cdcortesr/PowerSupplyDC_DC/README.md

# PowerSupplyDC_DC
Vin=34V, Vout=12V Iout=2A nom.
