cdcortesr/PowerSupplyDC_DC/Design.txt

3.5 x 1.5 mm	1206
2 x 1 mm	0805
10 x 10 mm 	ind 6r8
1.18 in x 0.86 (1.02) in

TS34063CS	Output switch current up to 1.5A
LTC1624		Peak Driver Output Current < 10µs (TG) ..... 2A
LM5085		4.5-V to 75-V Input Voltage Range
LM25085		4.5-V to 75-V Input Voltage Range
tl5001		missing design equations

Vin=34V
Vout=12v
Iout=2A max 4A

Max current different from peak switching current

SW Ipk=4.58 A

RFB2/RFB1 = (VOUT/1.25V) - 1 
RFB2= 80K6	RFB1= 9K372 = 270R + 9K1
Selected PFET: SQ3419AEEV-T1_GE3 max vds = -40V

the switching node area is kept to a reasonable minimum and the PFET peak current is derated to stay
within the recommended temperature rating of the PFET. The RDS(ON) of the PFET determines a portion of the
power dissipation in the PFET. However, PFETs with very low RDS(ON) usually have large values of gate charge.
A PFET with a higher gate charge has a corresponding slower switching speed, leading to higher switching
losses and affecting the PFET power dissipation.

Input operating current=1.25mA @ Vin=34V and =1.3mA @ Vin=40V
=======
Diode: MM3Z20VT1G better to use shottky: SK810L-TP

PMOS: SQ3419AEEV
