cdcortesr/PowerSupplyDC_DC/DesignCalculations.xlsx

Vin | 32
Vout | 12
Duty cycle | 0.375
Ton | 3.75e-07 | Should not be less than 150ns |  |  |  | Calculated 375ns
Td mosf | 2.3e-08 |  |  |  |  | 67 ns for Vishay SQ3419AEEV |  |  | 29-6
Td mosf + IC | 7.3e-08 | off-on delay in mosfet +50ns
Load maxcurrent | 3
Ripple current | 1 |  |  |  |  |  |  |  | Sink current | Offset voltage | -0.009 | 0 | 0.009
Icl (min) | 3.5 | Max current + half ripple |  |  |  |  |  |  | Min | 3.2e-05 | 3.58 | 4.48 | 5.38
Rsense | 0.01 |  |  |  |  |  |  |  | Nominal | 4e-05 | 4.7 | 5.6 | 6.5
Rsense Volt | 0.035 |  | Minimum voltage drop required to achieve Load max curr. |  |  |  |  |  | Max | 4.8e-05 | 5.82 | 6.72 | 7.62
min tripping voltage | 0.044 | + 9 mV max comp offset
Current at min trip voltage | 4.4
Radj | 1375 | Worst case scenario Radj using lowest sink current 32uA
Next avail res | 1400 |  | next higher avail value
I cl max | 7.62
I cl min | 3.58
Max power Radj | 0.036576
Max power Rsense | 0.580644
Freq | 1000000
Ton | 3.75e-07 | Should not be less than 150ns
Vin Ripple | 0.1
Cin | 1.125e-05
Cin Commercial | 1e-06 | 1uF | A higher value cap allowes for smaller Vin Ripple
Vf diode | 0.45 |  | 0.43 @25C |  | STPS5L60 | 5.4 x 3.625 mm |  | Max power 144W
D1 power | 1.035791075 | Must stand max Vin
Cvcc | 1uF | 0.47uF ceremic low ESR recommended
Rt | 63.31124138 |  | Calc value= 63k2 Ohms |  |  | Rt value in kOmhs
Comercial RT | 63.4 | E48 | Value in Kohms
Resulting Fsw | 983039.4683 |  | 0.983 Mhz
 |  | +Delay |  |  |  |  |  | SW of 1 Mhz just achieved at Vin=32V
Ton(min) @Vin max=42V | 2.822292536e-07 | 3.052292536e-07 | 299 ns higher than 150ns recommended |  |  |  | Freq | 1228584.73
Ton(max) @Vin min=20V | 5.589918937e-07 | 5.819918937e-07 | 575 ns |  |  |  | Freq | 644338.8715
Inductor value choosed so continous mode is obtained
Min Load current | 0.7
Max ripple current | 1.4 | 2 times min curr. |  | min current with neg half ripple current = 0 Amps
L1 | 6.04776972e-06 |  | 6 uH
Comercial L1 | 6.2e-06 |  | SRU1038-6R2Y |  | 10.00mm x 10.00mm |  |  | DCR 16.5 mOhm
Max ripple @L1 selected | 1.365625421
Max load current | 3.68281271
Vout ripple | 0.2
Cout | 8.682417293e-07 |  | 0.86uF, fromula dividing by 8 as they assume over half period half max ripple current and multiplied by 1/2 to obtain the area or the charge change
Comercial Cout | 10 |  |  |  | 0.125 |  | TCJA106M025R0150 |  | Size 1206
Resulting Vout ripple | 0.01736483459 |  | Following datasheet formula
ESR | 0.15
ESR ripple | 0.2048438131
Total V ripple | 0.2222086477
Vripple = Capacitive ripple + ESR ripple = Imax*D/(f*C) + Iripple *ESR
Power RT | 0.02782334385 | Worst case voltage
Power RFB1 | 0.01155625
Power RFB2 | 0.001358695652
SQ3419AEEV total gate charge | 8.4e-09 | 8.4 nC
Power Q1 | 0.3104 |  | +1.3mA from figure 2 datasheet
Temp rise power PAD | 16.7616
Temp rise No Power Pad | 47.4912
