cdcortesr/PowerSupplyDC_DC/Webench_design.PNG

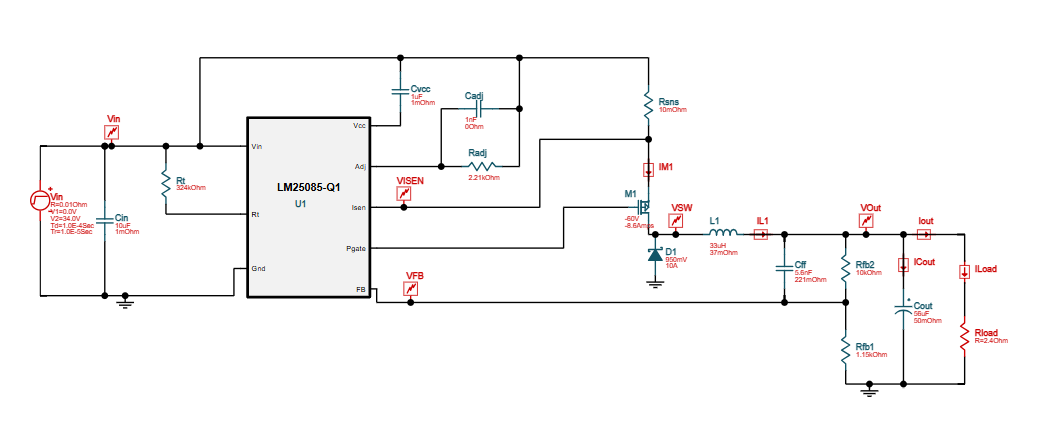
Webench_design.PNG
