cdcortesr/PowerSupplyDC_DC/BOM_JLCSMT.xlsx

Comment | Designator | Footprint | JLCPCB Part #（optional） | Mfr. Part # | Alternate Part | Description
1uF | C1 | Capacitor_SMD:C_1210_3225Metric_Pad1.33x2.70mm_HandSolder | C577270 | CC1210KKX7R0BB105 |  | 1 µF ±10% 100V Ceramic Capacitor X7R 1210
1uF | C2 | Capacitor_SMD:C_0402_1005Metric_Pad0.74x0.62mm_HandSolder | C1518208 | GRM155R61H105KE05D |  | 1 µF ±10% 50V Ceramic Capacitor X5R 0402 (1005 Metric)
1nF | C3 | Capacitor_SMD:C_0402_1005Metric_Pad0.74x0.62mm_HandSolder | C76947 | GRM1555C1H102JA01D |  | 1000 pF ±5% 50V Ceramic Capacitor C0G, NP0 0402
10uF | C4 | Capacitor_SMD:C_1206_3216Metric_Pad1.33x1.80mm_HandSolder | C2158829 | TCJA106M025R0150E |  | 10 µF Molded Tantalum Polymer Capacitor 25 V 1206
D_Schottky | D1 | Diode_SMD:D_SMC | C64338 | SK86C |  | Diode 60 V 8A Surface Mount DO-214AB (SMC)
6.2uF | L01 | Inductor_SMD:L_Bourns-SRU1028_10.0x10.0mm | C7084591 | SRU1038-6R2Y |  | 6.2 µH Shielded Drum Core, Wirewound Inductor 4 A 16.5mOhm Nonstandard (n Current up to 7.2 A)
LM25085 | U1 | Package_SO:HVSSOP-8-1EP_3x3mm_P0.65mm_EP1.57x1.89mm_ThermalVias | C2650243 | LM25085MY/NOPB |  | Buck Regulator Positive Output Step-Down DC-DC Controller IC 8-HVSSOP
63k4 | R1 | Resistor_SMD:R_0805_2012Metric_Pad1.20x1.40mm_HandSolder | C2933483 | FRC0805F6342TS | ERA-6AEB6342V | 125mW Thick Film Resistor 150V ±100ppm/? ±1% 63.4k? 0805 Chip Resistor - Surface Mount ROHS
1k4 | R2 | Resistor_SMD:R_0805_2012Metric_Pad1.20x1.40mm_HandSolder | C2930161 | FRC0805F1401TS | RC0805FR-071K4L | 125mW Thick Film Resistor 150V ±100ppm/? ±1% 1.4k? 0805 Chip Resistor - Surface Mount ROHS
0R01 | R3 | Resistor_SMD:R_1206_3216Metric_Pad1.30x1.75mm_HandSolder | C2903499 | HoJLR1206-1W-10mR-1% | ERJ-8CWFR010V | 1W 10m? Surface Mount Current Sense Resistor ±1% 1206 Current Sense Resistors / Shunt Resistors ROHS
10k | R4 | Resistor_SMD:R_0805_2012Metric_Pad1.20x1.40mm_HandSolder | C2930231 | FRC0805J103TS | ERJ-6GEYJ103V | 125mW Thick Film Resistor 150V ±100ppm/? ±5% 10k? 0805 Chip Resistor - Surface Mount ROHS
1k15 | R5 | Resistor_SMD:R_0805_2012Metric_Pad1.20x1.40mm_HandSolder | C3016680 | SCR0805F1K15 | CRCW08051K15FKEA | 125mW Thick Film Resistor 150V ±100ppm/? ±1% 1.15k? 0805 Chip Resistor - Surface Mount ROHS
SQ3419AEEV | Q1 | Package_SO:TSOP-6_1.65x3.05mm_P0.95mm | C727535 | SQ3419AEEV-T1_GE3 |  | 40V 6.9A 61m?@10V,2.5A 2.5V TSOP-6 MOSFETs ROHS
