cdcortesr/PowerSupplyDC_DC/PowerSupply.kicad_pcb

## KiCad design PowerSupply.kicad_pcb (2025-09-02)

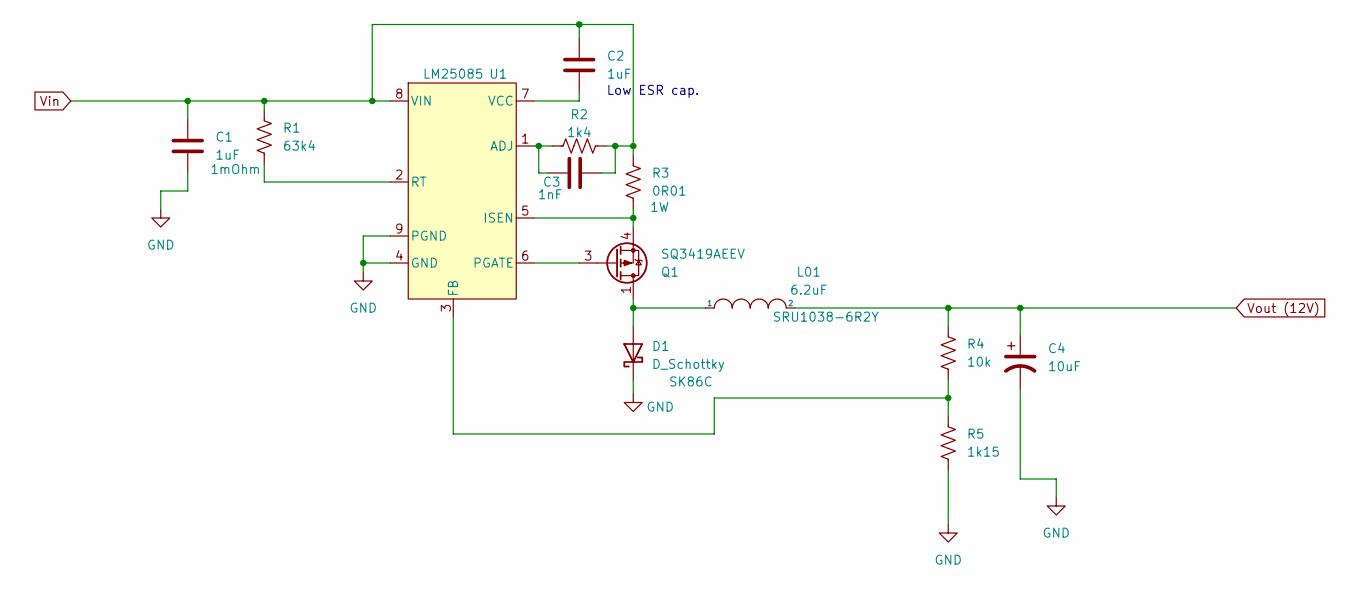
[picture p2: schematic PowerSupply.kicad_sch]

Parts:
C1: 1uF; C_1210_3225Metric_Pad1.33x2.70mm_HandSolder; MFR Part # CC1210KKX7R0BB105; LCSC Part # C577270
C2: 1uF; C_0402_1005Metric_Pad0.74x0.62mm_HandSolder; MFR Part # GRM155R61H105KE05D; LCSC Part # C1518208
C3: 1nF; C_0402_1005Metric_Pad0.74x0.62mm_HandSolder; MFR Part # GRM1555C1H102JA01D; LCSC Part # C76947
C4: 10uF; C_1206_3216Metric_Pad1.33x1.80mm_HandSolder; MFR Part # TCJA106M025R0150E; LCSC Part # C2158829
D1: D_Schottky; D_SMC; MFR Part # SK86C; LCSC Part # C64338
L01: 6.2uF; L_Bourns-SRU1028_10.0x10.0mm; MFR Part # SRU1038-6R2Y; LCSC Part # C7084591
Q1: SQ3419AEEV; TSOP-6_1.65x3.05mm_P0.95mm; MFR Part # LM25085MY/NOPB; LCSC Part # C2650243
R1: 63k4; R_0805_2012Metric_Pad1.20x1.40mm_HandSolder; MFR Part # FRC0805F6342TS; LCSC Part # C2933483
R2: 1k4; R_0805_2012Metric_Pad1.20x1.40mm_HandSolder; MFR Part # FRC0805F1401TS; LCSC Part # C2930161
R3: 0R01; R_1206_3216Metric_Pad1.30x1.75mm_HandSolder; MFR Part # HoJLR1206-1W-10mR-1%; LCSC Part # C2903499
R4: 10k; R_0805_2012Metric_Pad1.20x1.40mm_HandSolder; MFR Part # FRC0805J103TS; LCSC Part # C2930231
R5: 1k15; R_0805_2012Metric_Pad1.20x1.40mm_HandSolder; MFR Part # SCR0805F1K15; LCSC Part # C3016680
U1: LM25085; HVSSOP-8-1EP_3x3mm_P0.65mm_EP1.57x1.89mm_ThermalVias; MFR Part # SQ3419AEEV-T1_GE3; LCSC Part # C727535

Connections:
GND: C1.2, C4.2, D1.1 (K), R5.2, U1.4 (GND), U1.9 (PGND)
unnamed: D1.2 (A), L01.1, Q1.1 (D), Q1.2 (D), Q1.5 (D), Q1.6 (D)
unnamed: Q1.3 (G), U1.6 (PGATE)
unnamed: Q1.4 (S), R3.2, U1.5 (ISEN)
unnamed: C3.1, R2.1, U1.1 (ADJ)
unnamed: R4.2, R5.1, U1.3 (FB)
unnamed: R1.2, U1.2 (RT)
unnamed: C2.2, U1.7 (VCC)
Vin: C1.1, C2.1, C3.2, R1.1, R2.2, R3.1, U1.8 (VIN)
Vout (12V): C4.1, L01.2, R4.1

Notes on the sheet:
Low ESR cap.

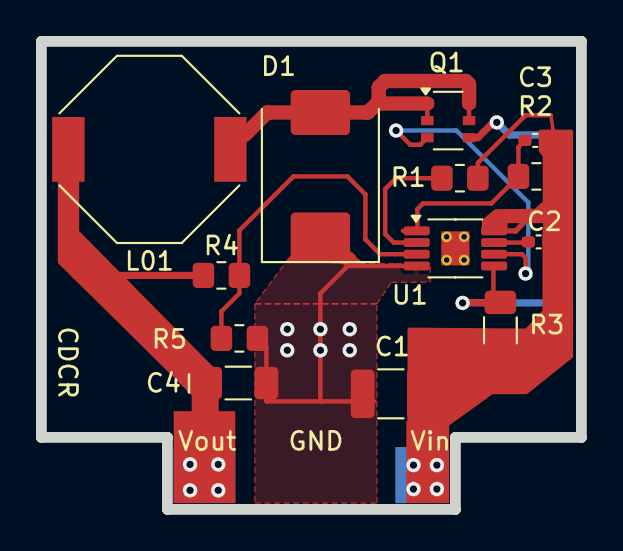
[picture p3: board PowerSupply.kicad_pcb from above]

Board: 2 copper layers, 30.0 x 26.0 mm, 13 parts (0 on the bottom side), 10 nets.
