cdcortesr/PowerSupplyDC_DC/(commit log)

2025-08-18 Initial upload
    [PowerSupply.kicad_pcb, PowerSupply.kicad_sch]
2025-08-18 Second commit
    [PowerSupply.kicad_pcb, PowerSupply.kicad_sch]
2025-08-19 PMOS update
    [PowerSupply.kicad_sch]
2025-08-21 Update Schm 08/21
    [PowerSupply.kicad_sch]
2025-08-21 Sch update 08/21
    [PowerSupply.kicad_pcb, PowerSupply.kicad_sch]
2025-08-25 Update 08/24
    [DesignCalculations.xlsx, PowerSupply.kicad_pcb, PowerSupply.kicad_sch]
2025-08-25 Update 08/25
    [PowerSupply.kicad_pcb]
2025-08-26 update 08-26
    [PowerSupply.kicad_pcb]
2025-08-27 update 08-27
    [PowerSupply.kicad_pcb]
2025-08-28 Update 27-08
    [PowerSupply.kicad_pcb]
2025-08-28 Update 08-28
    [BOM.csv, DesignCalculations.xlsx]
2025-08-29 Update 08-29
    [BOM_JLCSMT.xlsx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]
2025-09-02 Final Layout
    [BOM_JLCSMT.xlsx, PowerSupply.kicad_pcb, PowerSupply.kicad_sch]
